styf/synth-mate/docs/64500295_00_K.pdf

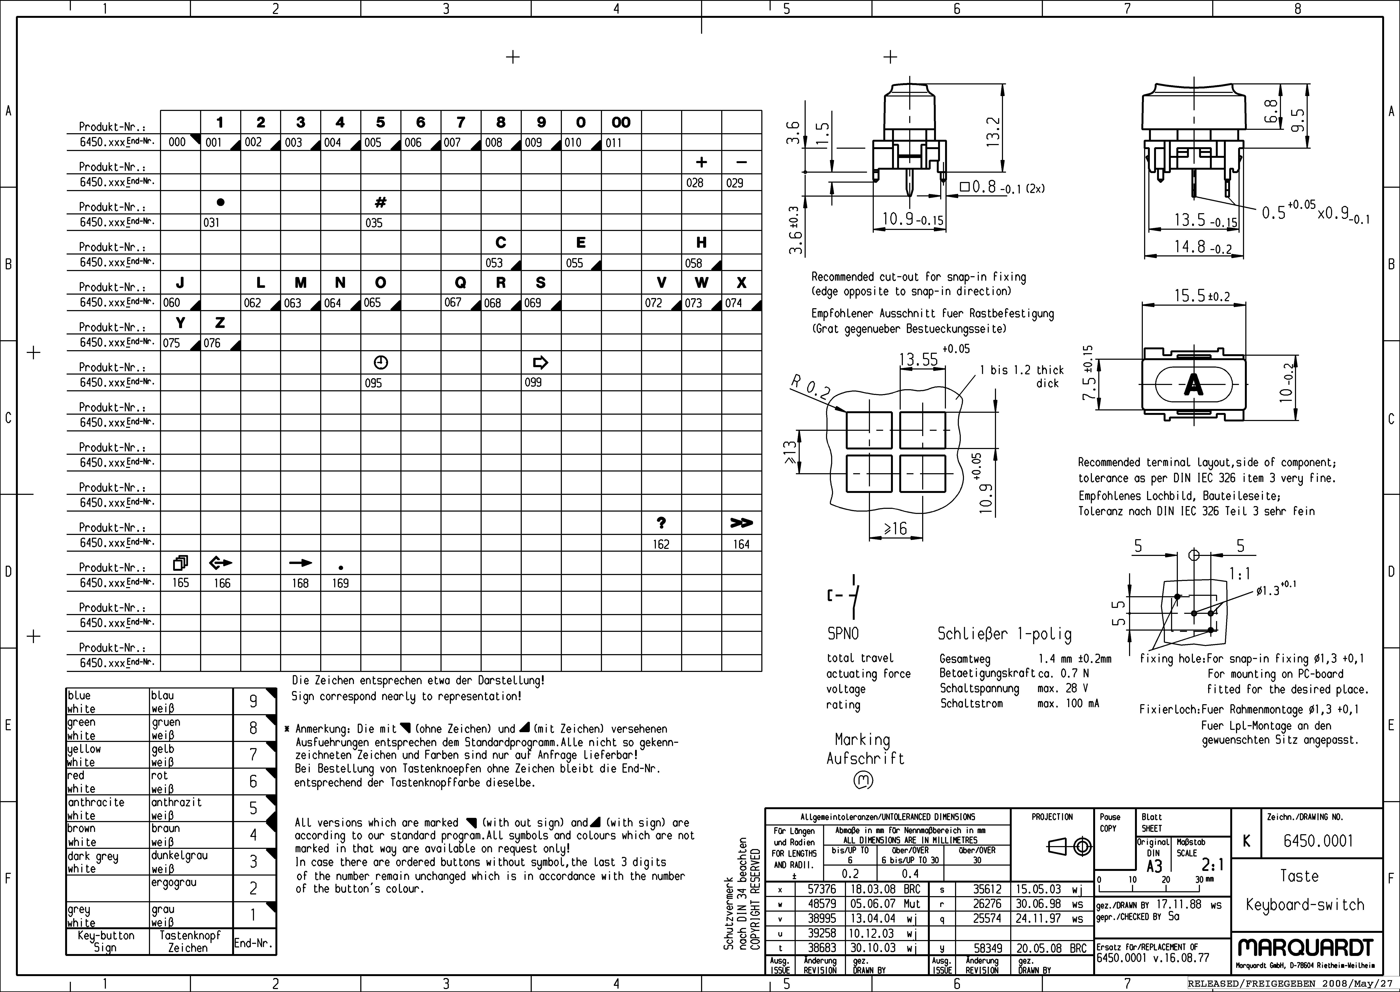
[picture p1: page 1]
