styf/synth-mate/synthmate_hyna_L432/synthmate_L432.step

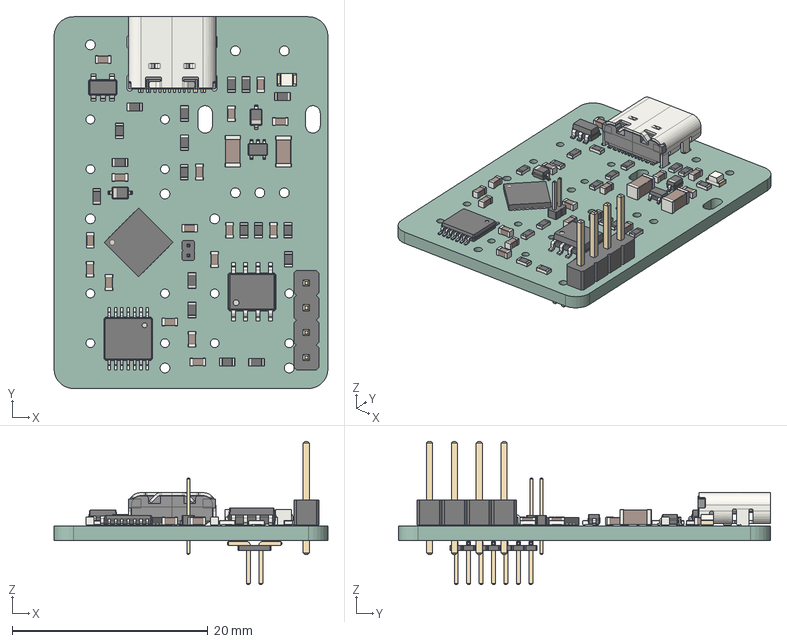
[picture p2: CAD file, 2026-01-29]
synthmate_hyna_L432/synthmate_L432.step
28.0 x 38.0 x 14.6 mm
PinHeader_1x04_P2.54mm_Vertical
TSSOP-14_4.4x5mm_P0.65mm
C_0603_1608Metric x 16
R_0603_1608Metric x 18
USB_C_Receptacle_GCT_USB4105-xx-A_16P_TopMnt_Horizontal
D_SOD-323 x 2
SOIC-8_3.9x4.9mm_P1.27mm
SOT-353_SC-70-5
SOT-23-5
LED_0805_2012Metric
C_1206_3216Metric x 2
QFN-32-1EP_5x5mm_P0.5mm_EP3.45x3.45mm
PinHeader_1x02_P1.00mm_Vertical
PinHeader_2x07_P1.27mm_Vertical_SMD
synthmate_L432_PCB
