styf/synth-mate/synthmate_hyna_L432/synthmate_L432.pdf

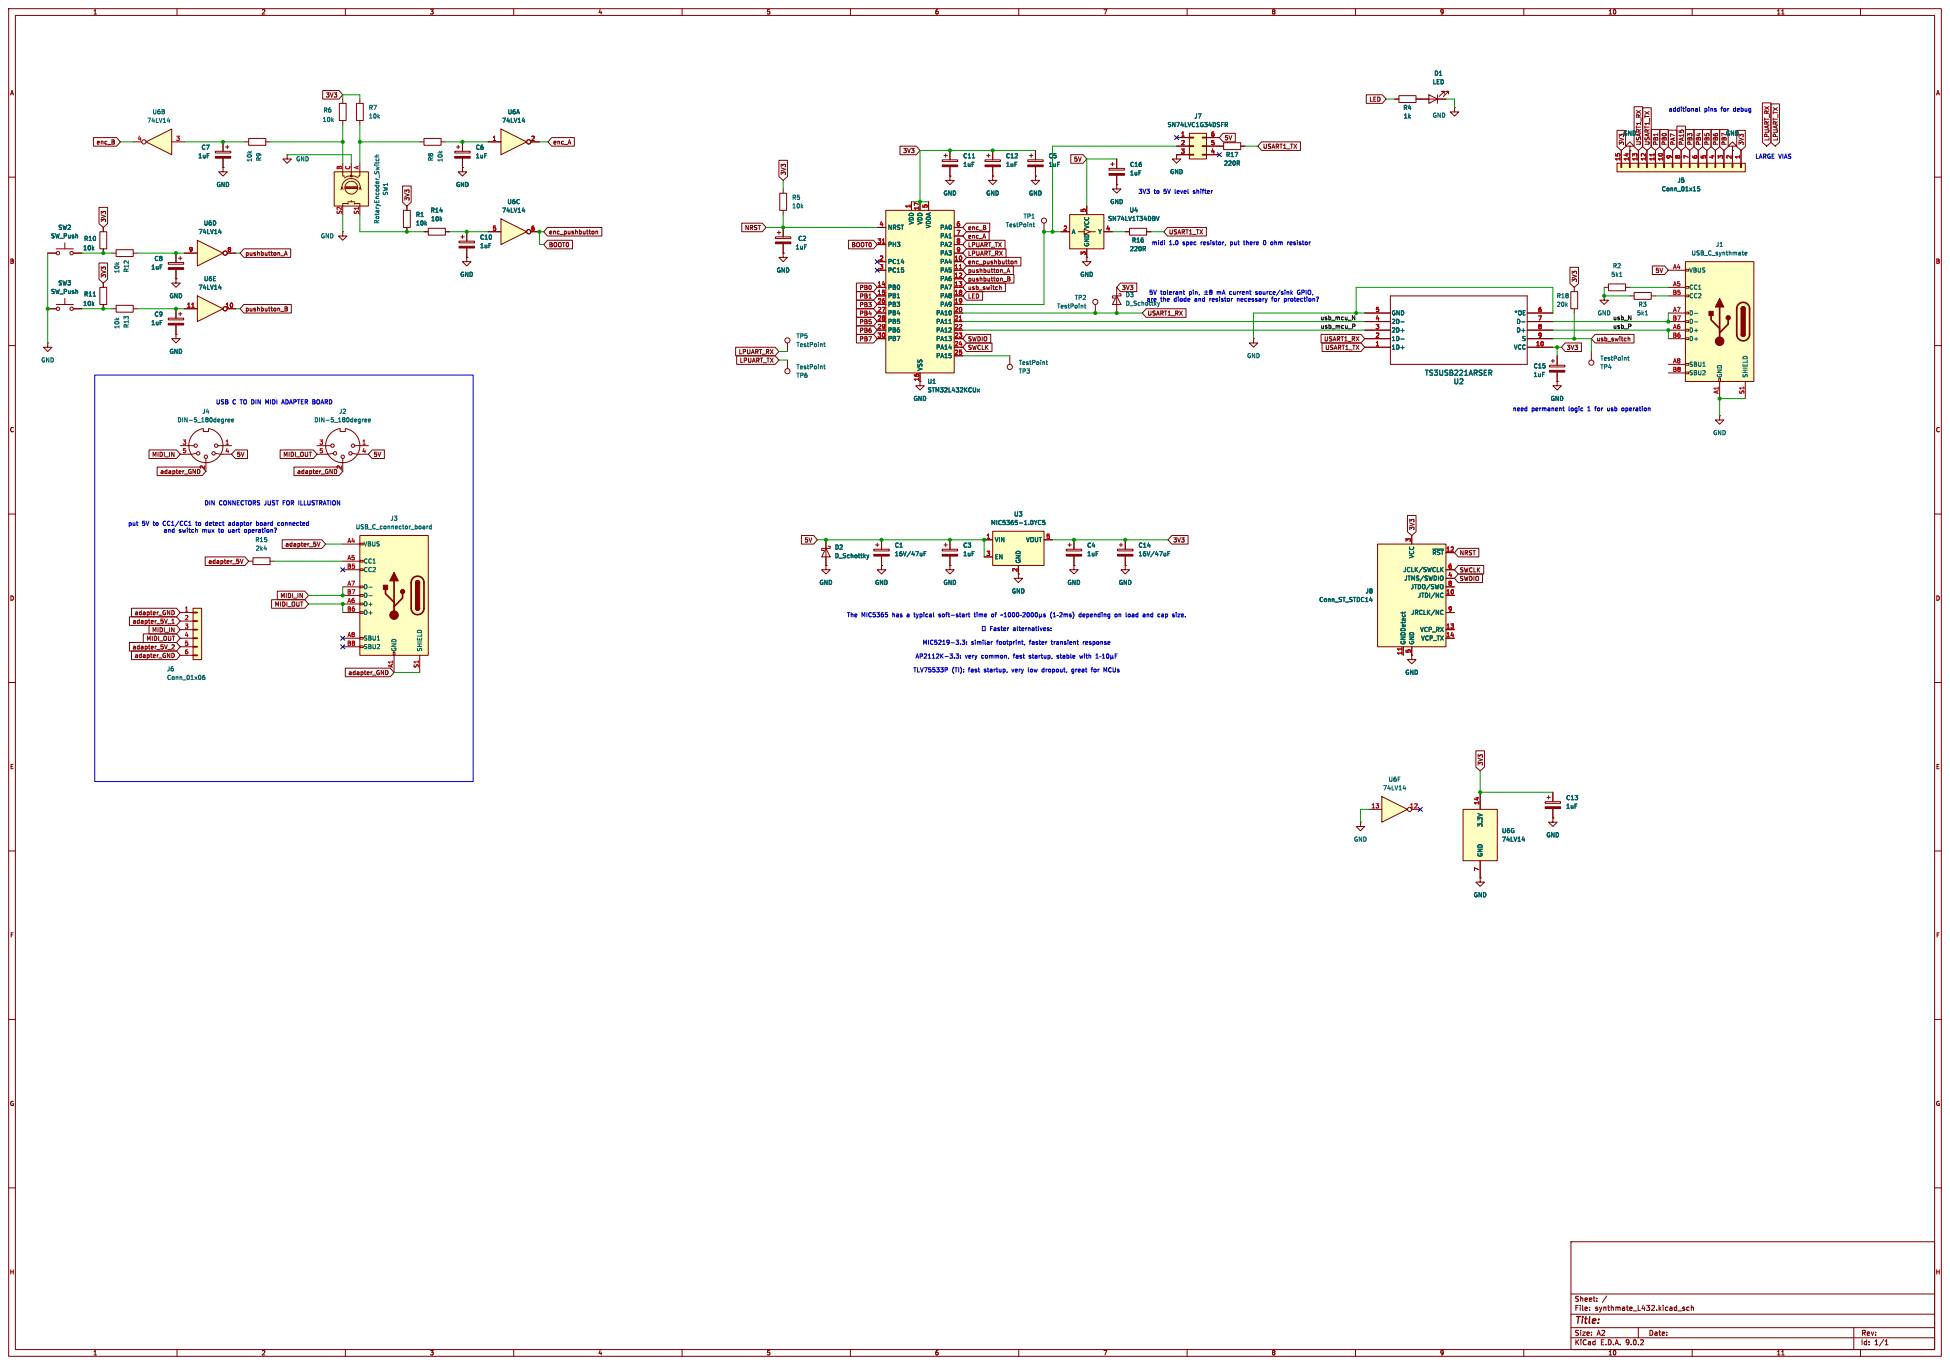
[picture p3: page 1]

usb_P DIN CONNECTORS JUST FOR ILLUSTRATION

USB C TO DIN MIDI ADAPTER BOARD

put 5V to CC1/CC1 to detect adaptor board connected

and switch mux to uart operation?
