styf/synth-mate/synthmate_hyna_L432/synthmate_L432.kicad_pcb

## KiCad design synthmate_hyna_L432/synthmate_L432.kicad_pcb (2026-01-23)

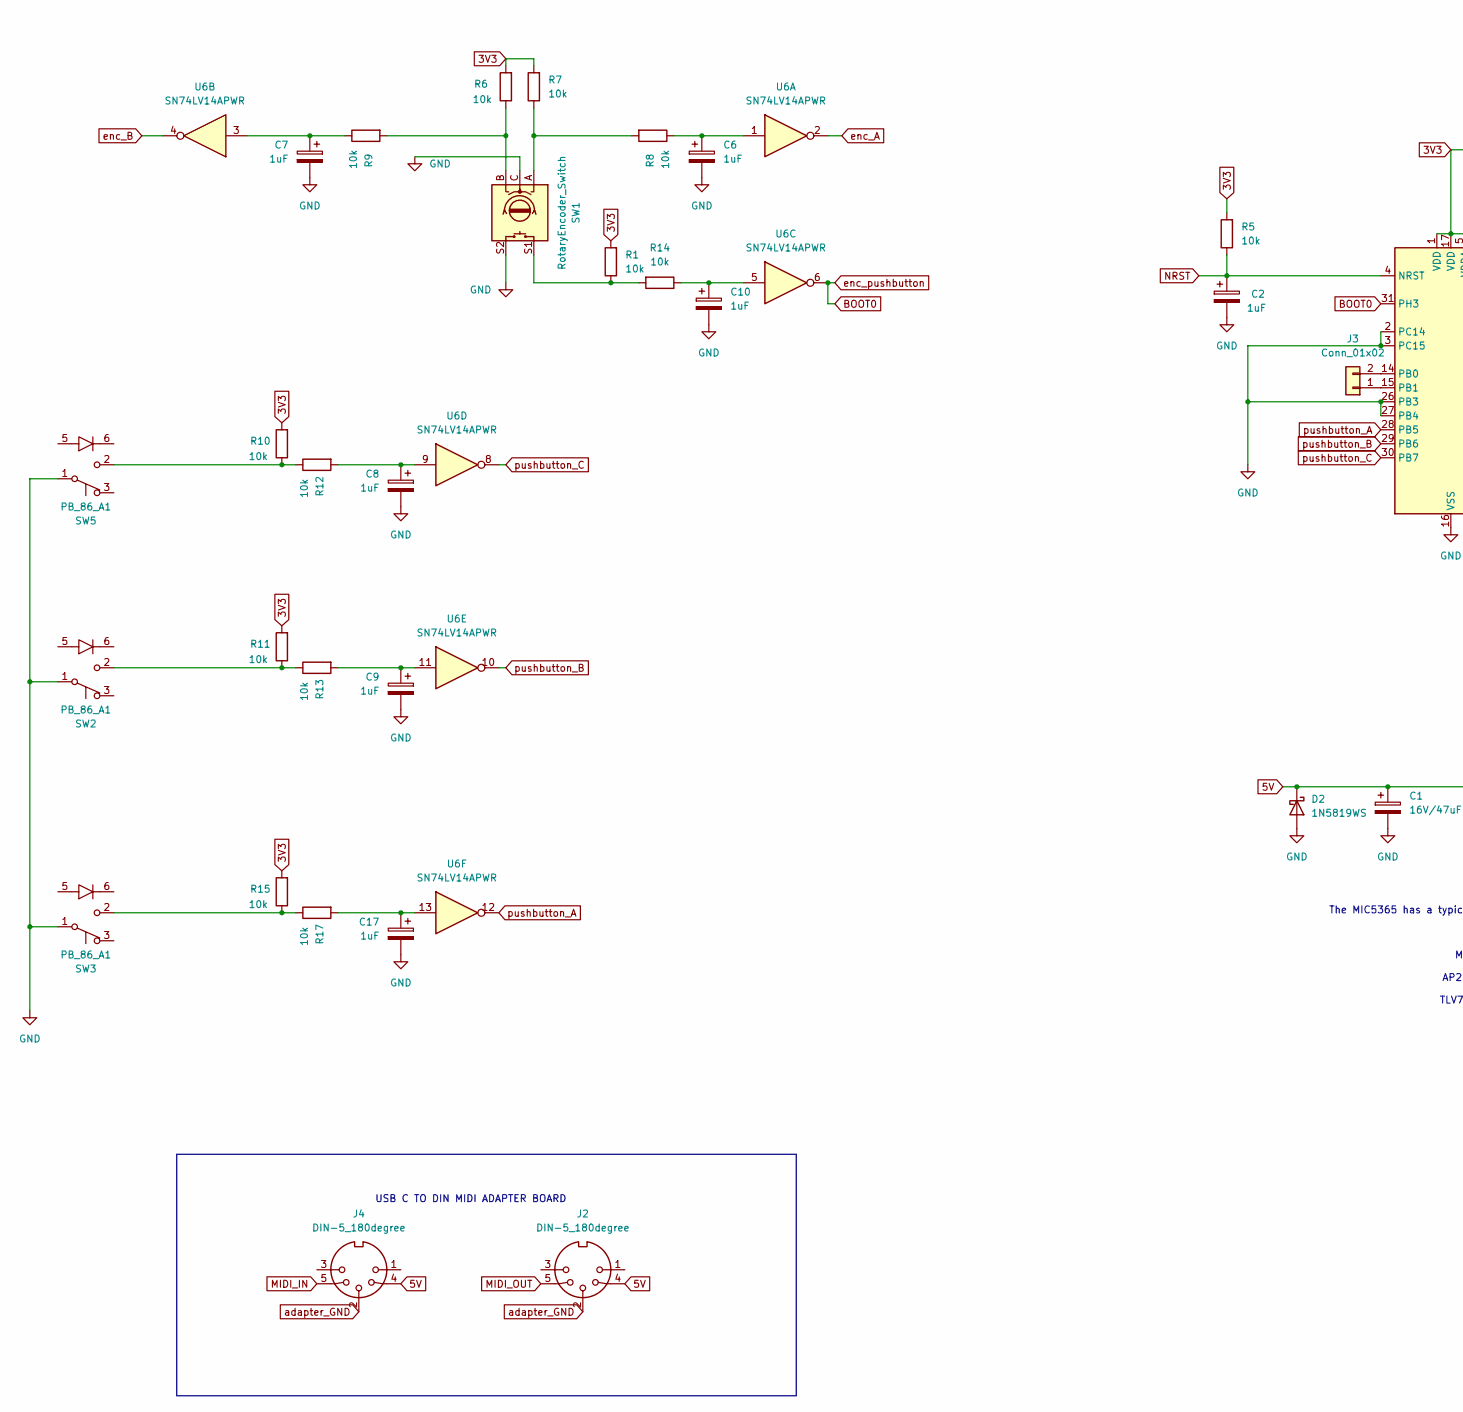
[picture p4: schematic synthmate_L432.kicad_sch, part in row 1, column 1]

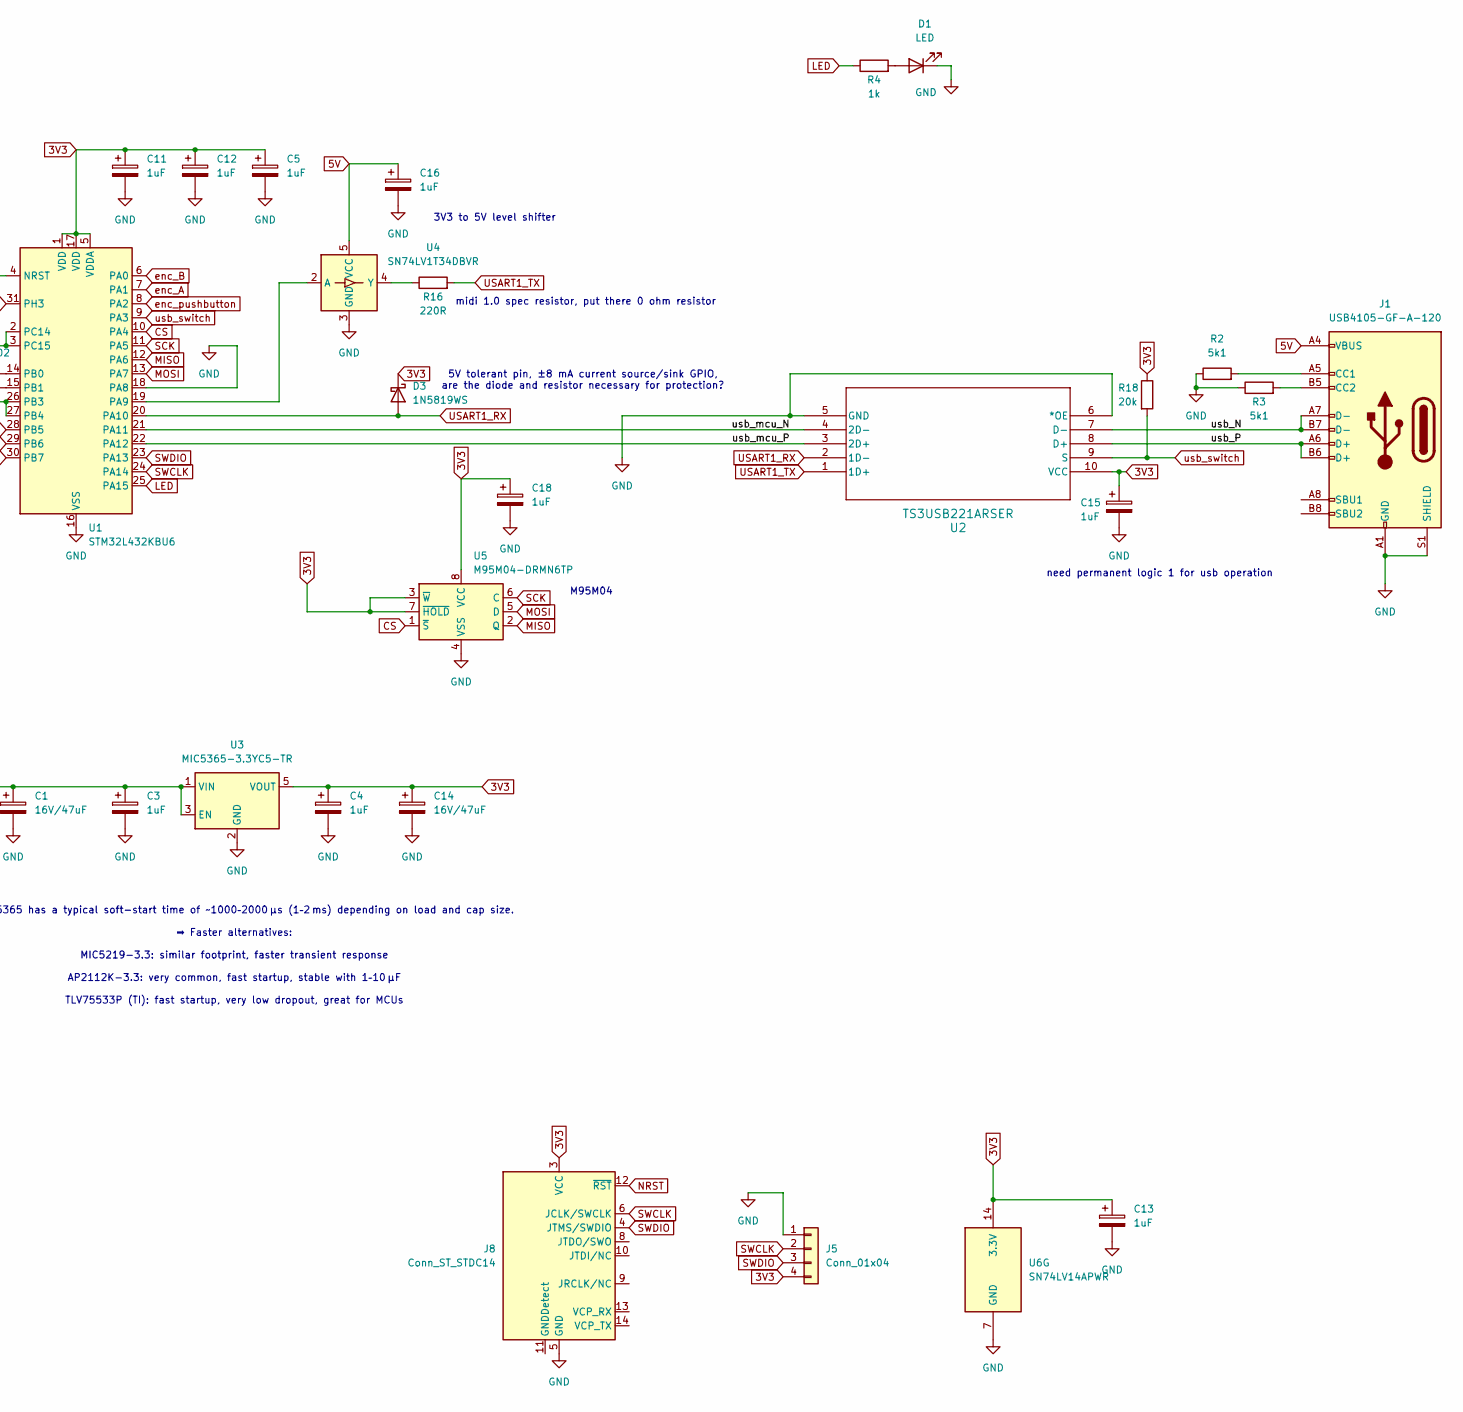
[picture p5: schematic synthmate_L432.kicad_sch, part in row 1, column 2]

Parts:
C1, C14: 16V/47uF; C_1206_3216Metric
C2, C3, C4, C5, C6, C7, C8, C9, C10, C11, C12, C13, C15, C16, C17, C18: 1uF; C_0603_1608Metric
D1: LED; LED_0805_2012Metric_Pad1.15x1.40mm_HandSolder
D2, D3: 1N5819WS; D_SOD-323
J1: USB4105-GF-A-120; USB_C_Receptacle_GCT_USB4105-xx-A_16P_TopMnt_Horizontal
J2, J4: DIN-5_180degree
J3: Conn_01x02; PinHeader_1x02_P1.00mm_Vertical
J5: Conn_01x04; PinHeader_1x04_P2.54mm_Vertical
J8: Conn_ST_STDC14; PinHeader_2x07_P1.27mm_Vertical_SMD
R1, R5, R6, R7, R8, R9, R10, R11, R12, R13, R14, R15, R17: 10k; R_0603_1608Metric
R2, R3: 5k1; R_0603_1608Metric
R4: 1k; R_0603_1608Metric
R16: 220R; R_0603_1608Metric
R18: 20k; R_0603_1608Metric
SW1: RotaryEncoder_Switch; RotaryEncoder_Alps_EC11E-Switch_Vertical_H20mm
SW2, SW3, SW5: PB_86_A1; PB_86_A0
U1: STM32L432KBU6; QFN-32-1EP_5x5mm_P0.5mm_EP3.45x3.45mm
U2: TS3USB221ARSER; RSE10
U3: MIC5365-3.3YC5-TR; SOT-353_SC-70-5
U4: SN74LV1T34DBVR; SOT-23-5
U5: M95M04-DRMN6TP; SOIC-8_3.9x4.9mm_P1.27mm
U6: SN74LV14APWR; TSSOP-14_4.4x5mm_P0.65mm

Connections:
3V3: C4.1, C5.1, C11.1, C12.1, C13.1, C14.1, C15.1, C18.1, D3.1 (K), J5.4, J8.3 (VCC), R1.2, R5.2, R6.2, R7.2, R10.2, R11.2, R15.2, R18.1, U1.1 (VDD), U1.5 (VDDA), U1.17 (VDD), U2.10 (VCC), U3.5 (VOUT), U5.3 (~W), U5.7 (~HOLD), U5.8 (VCC), U6.14 (3.3V)
5V: C1.1, C3.1, C16.1, D2.1 (K), J1.A4 (VBUS), J1.A9 (VBUS), J1.B4 (VBUS), J1.B9 (VBUS), J2.4, J4.4, U3.1 (VIN), U3.3 (EN), U4.5 (VCC)
/usb_N: J1.A7 (D-), J1.B7 (D-), U2.7 (D-)
/usb_P: J1.A6 (D+), J1.B6 (D+), U2.8 (D+)
/usb_mcu_N: U1.21 (PA11), U2.4 (2D-)
/usb_mcu_P: U1.22 (PA12), U2.3 (2D+)
BOOT0: U1.8 (PA2), U1.31 (PH3), U6.6
CS: U1.10 (PA4), U5.1 (~S)
GND: C1.2, C2.2, C3.2, C4.2, C5.2, C6.2, C7.2, C8.2, C9.2, C10.2, C11.2, C12.2, C13.2, C14.2, C15.2, C16.2, C17.2, C18.2, D1.1 (K), D2.2 (A), J1.A1 (GND), J1.A12 (GND), J1.B1 (GND), J1.B12 (GND), J1.S1 (SHIELD), J5.1, J8.5 (GND), J8.7 (GND), R2.1, R3.1, SW1.C, SW1.S2, SW2.1 (B), SW3.1 (B), SW5.1 (B), U1.2 (PC14), U1.3 (PC15), U1.16 (VSS), U1.18 (PA8), U1.26 (PB3), U1.27 (PB4), U1.32 (VSS), U1.33 (VSS), U2.5 (GND), U2.6 (*OE), U3.2 (GND), U4.3 (GND), U5.4 (VSS), U6.7 (GND)
LED: R4.1, U1.25 (PA15)
MISO: U1.12 (PA6), U5.2 (Q)
MOSI: U1.13 (PA7), U5.5 (D)
NRST: C2.1, J8.12 (~RST), R5.1, U1.4 (NRST)
unnamed: C6.1, R8.1, U6.1
unnamed: C7.1, R9.1, U6.3
unnamed: C8.1, R12.2, U6.9
unnamed: C9.1, R13.2, U6.11
unnamed: C10.1, R14.1, U6.5
unnamed: C17.1, R17.2, U6.13
unnamed: D1.2 (A), R4.2
unnamed: J1.A5 (CC1), R2.2
unnamed: J1.B5 (CC2), R3.2
unnamed: J2.2, J4.2
unnamed: J3.1, U1.15 (PB1)
unnamed: J3.2, U1.14 (PB0)
unnamed: R1.1, R14.2, SW1.S1
unnamed: R6.1, R9.2, SW1.B
unnamed: R7.1, R8.2, SW1.A
unnamed: R11.1, R13.1, SW2.2 (C)
unnamed: R15.1, R17.1, SW3.2 (C)
unnamed: R10.1, R12.1, SW5.2 (C)
unnamed: U1.19 (PA9), U4.2 (A)
unnamed: R16.1, U4.4 (Y)
SCK: U1.11 (PA5), U5.6 (C)
SWCLK: J5.2, J8.6 (JCLK/SWCLK), U1.24 (PA14)
SWDIO: J5.3, J8.4 (JTMS/SWDIO), U1.23 (PA13)
USART1_RX: D3.2 (A), U1.20 (PA10), U2.2 (1D-)
USART1_TX: R16.2, U2.1 (1D+)
enc_A: U1.7 (PA1), U6.2
enc_B: U1.6 (PA0), U6.4
pushbutton_A: U1.28 (PB5), U6.12
pushbutton_B: U1.29 (PB6), U6.10
pushbutton_C: U1.30 (PB7), U6.8
usb_switch: R18.2, U1.9 (PA3), U2.9 (S)

Notes on the sheet:
The MIC5365 has a typical soft-start time of ~1000–2000 µs (1–2 ms) depending on load and cap size. ➡️ Faster alternatives: MIC5219-3.3: similar footprint, faster transient response AP2112K-3.3: very common, fast startup, stable with 1–10 µF TLV75533P (TI): fast startup, very low dropout, great for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
M95M04
5V tolerant pin, ±8 mA current source/sink GPIO, are the diode and resistor necessary for protection?
3V3 to 5V level shifter
need permanent logic 1 for usb operation
USB C TO DIN MIDI ADAPTER BOARD
midi 1.0 spec resistor, put there 0 ohm resistor

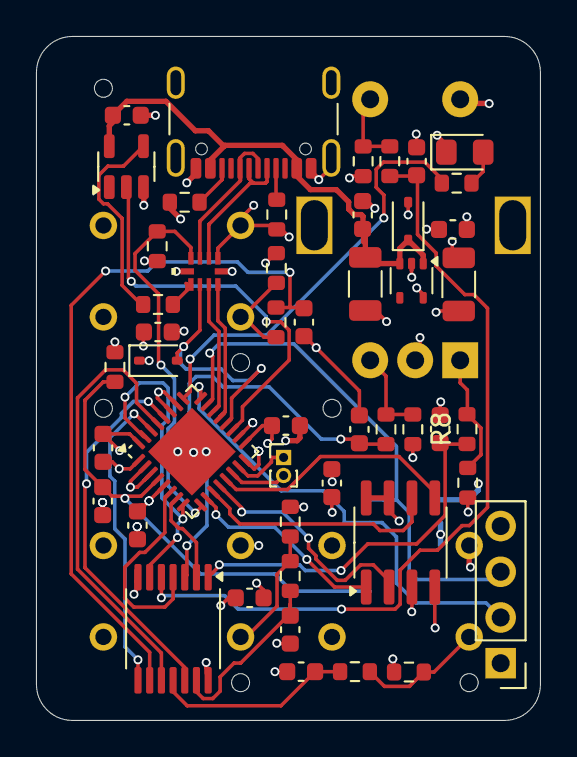
[picture p6: board synthmate_hyna_L432/synthmate_L432.kicad_pcb from above]

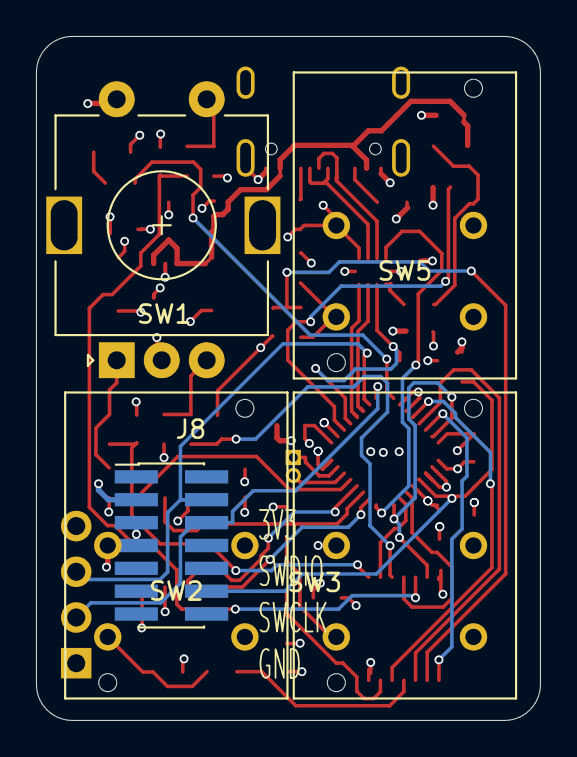
[picture p7: board synthmate_hyna_L432/synthmate_L432.kicad_pcb from below]

Board: 4 copper layers, 28.0 x 38.0 mm, 53 parts (5 on the bottom side), 43 nets.
