styf/synth-mate/synthmate_L432/synthmate_L432.kicad_pcb

## KiCad design synthmate_L432/synthmate_L432.kicad_pcb (2025-06-26)

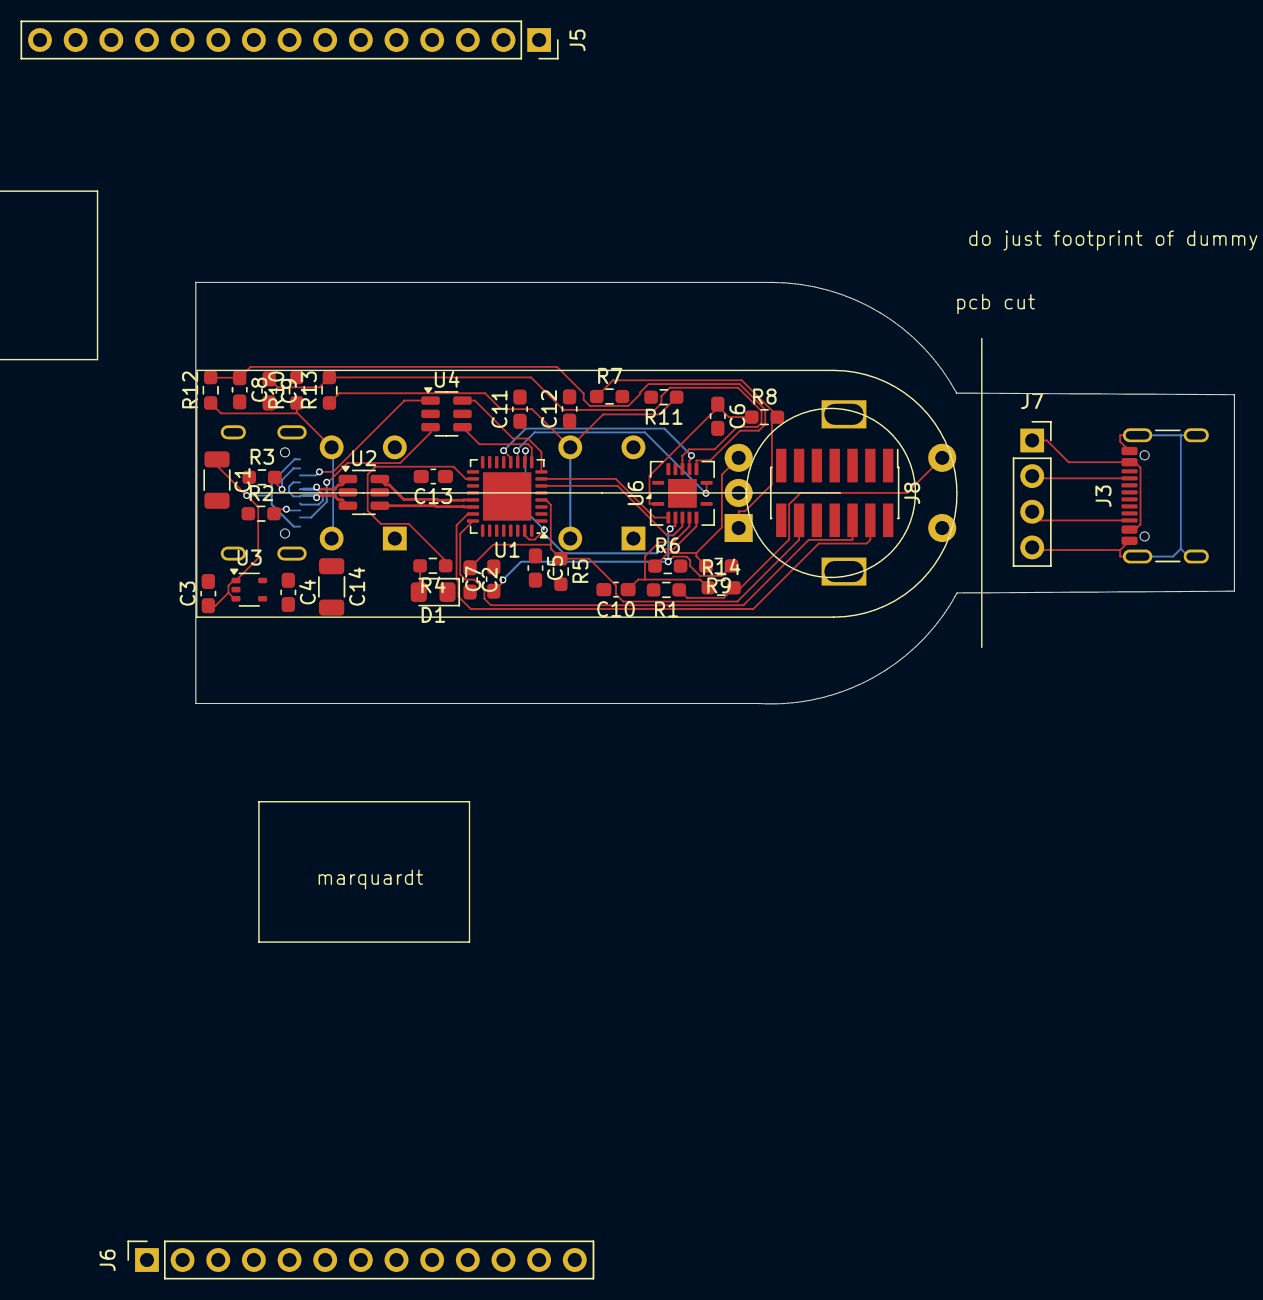
[picture p8: board synthmate_L432/synthmate_L432.kicad_pcb from above]

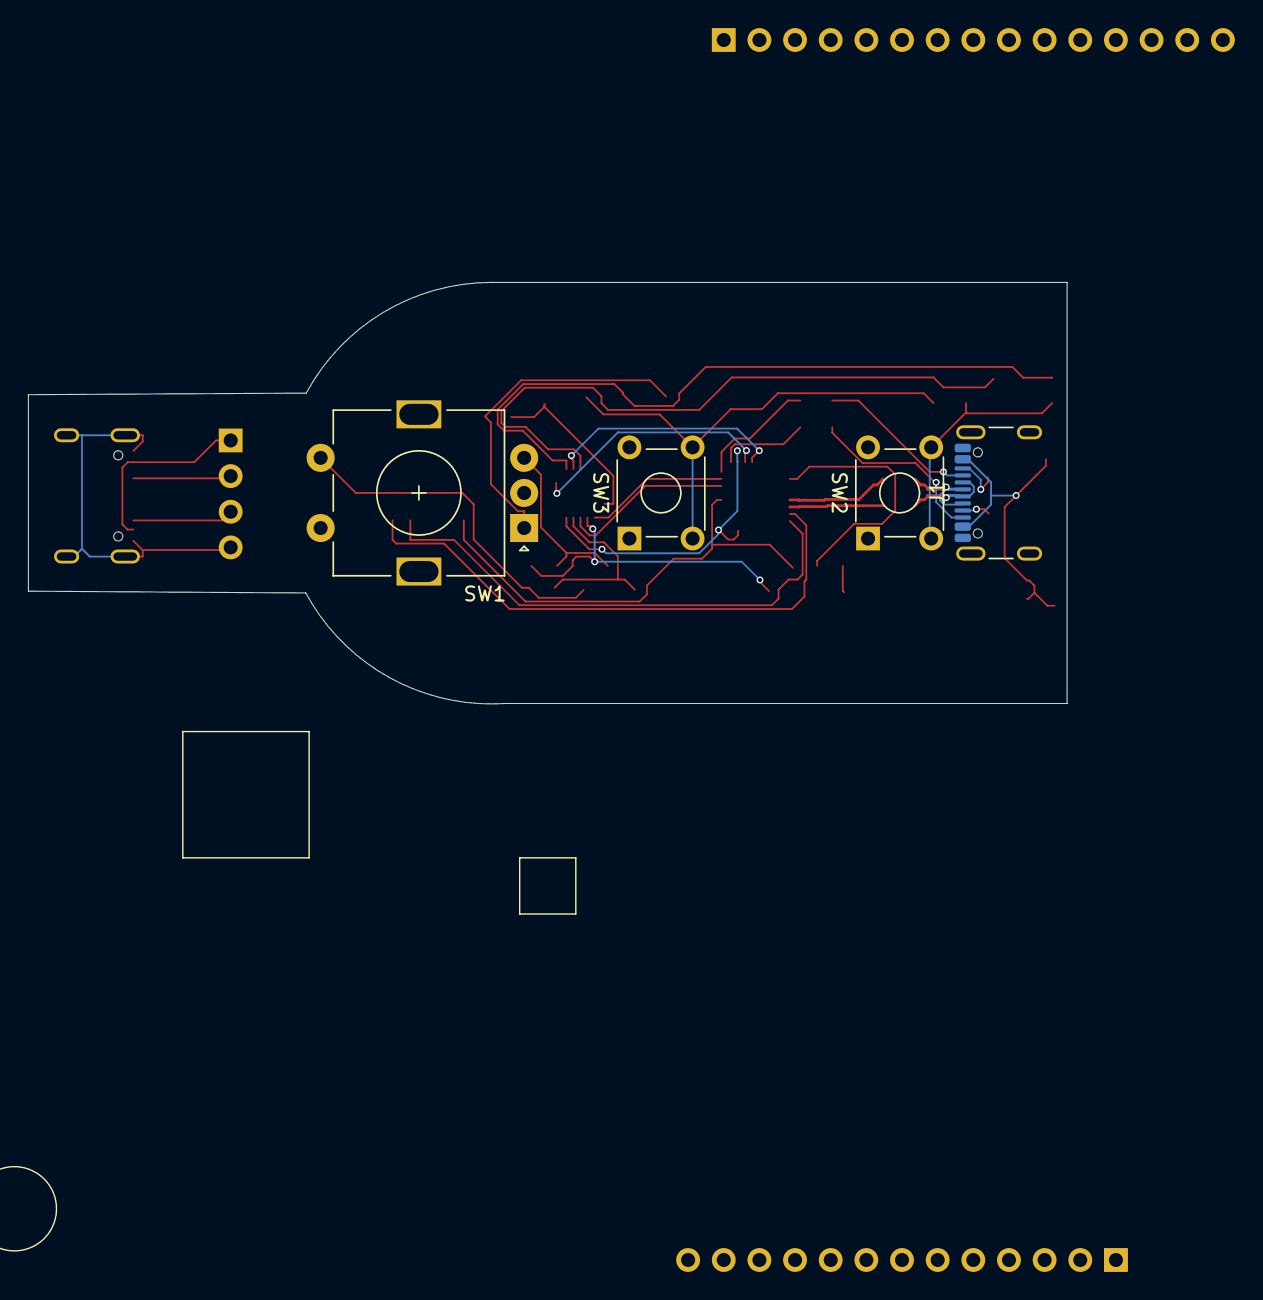
[picture p9: board synthmate_L432/synthmate_L432.kicad_pcb from below]

Board: 4 copper layers, 74.0 x 30.0 mm, 43 parts (4 on the bottom side), 37 nets.

Parts:
C1, C14: 16V/47uF; C_1206_3216Metric
C2, C5, C6, C7, C8, C9, C10, C11, C12: 100nF; C_0603_1608Metric_Pad1.08x0.95mm_HandSolder
C3, C4, C13: 1uF; C_0603_1608Metric_Pad1.08x0.95mm_HandSolder
D1: LED; LED_0805_2012Metric_Pad1.15x1.40mm_HandSolder
J1: USB_C_synthmate; USB_C_Receptacle_GCT_USB4105-xx-A_16P_TopMnt_Horizontal
J3: USB_C_connector_board; USB_C_Receptacle_GCT_USB4105-xx-A_16P_TopMnt_Horizontal
J5: Conn_01x16; PinSocket_1x15_P2.54mm_Vertical
J6: Conn_01x13; PinSocket_1x13_P2.54mm_Vertical
J7: Conn_01x04; PinSocket_1x04_P2.54mm_Vertical
J8: Conn_ST_STDC14; PinHeader_2x07_P1.27mm_Vertical_SMD
R1, R5, R6, R7, R8, R9, R10, R11, R12, R13, R14: 10k; R_0603_1608Metric_Pad0.98x0.95mm_HandSolder
R2, R3: 5k1; R_0603_1608Metric_Pad0.98x0.95mm_HandSolder
R4: 1k; R_0603_1608Metric_Pad0.98x0.95mm_HandSolder
SW1: RotaryEncoder_Switch; RotaryEncoder_Alps_EC11E-Switch_Vertical_H20mm
SW2, SW3: SW_Push; SW_TH_Tactile_Omron_B3F-10xx
U1: STM32L432KCUx; QFN-32-1EP_5x5mm_P0.5mm_EP3.45x3.45mm
U2, U4: USBLC6-2SC6; SOT-23-6
U3: MIC5365-1.0YC5; SOT-353_SC-70-5
U6: 74LV14; Texas_S-PVQFN-N14

Connections:
3V3: C4.1, C5.1, C11.1, C12.1, C13.1, C14.1, J8.3 (VCC), R1.2, R5.2, R6.2, R7.2, R10.2, R11.2, U1.1 (VDD), U1.5 (VDDA), U1.17 (VDD), U2.5 (VBUS), U3.5 (VOUT), U4.5 (VBUS), U6.14 (3.3V)
5V: C1.1, C3.1, J1.A4 (VBUS), J1.A9 (VBUS), J1.B4 (VBUS), J1.B9 (VBUS), U3.1 (VIN), U3.3 (EN)
/usb+: U1.22 (PA12), U2.4 (I/O2)
/usb-: U1.21 (PA11), U2.6 (I/O1)
/usb_N: J1.A7 (D-), J1.B7 (D-), U2.1 (I/O1)
/usb_P: J1.A6 (D+), J1.B6 (D+), U2.3 (I/O2)
BOOT0: U1.10 (PA4), U1.31 (PH3), U6.6
GND: C1.2, C2.2, C3.2, C4.2, C5.2, C6.2, C7.2, C8.2, C9.2, C10.2, C11.2, C12.2, C13.2, C14.2, D1.1 (K), J1.A1 (GND), J1.A12 (GND), J1.B1 (GND), J1.B12 (GND), J1.S1 (SHIELD), J8.5 (GND), J8.7 (GND), R2.1, R3.1, SW1.C, SW1.S2, SW2.1, SW3.1, U1.16 (VSS), U1.32 (VSS), U1.33 (VSS), U2.2 (GND), U3.2 (GND), U4.2 (GND), U6.7 (GND), U6.13
LED: R4.1, U1.18 (PA8)
LPUART_RX: U1.9 (PA3), U4.4 (I/O2)
LPUART_TX: U1.8 (PA2), U4.6 (I/O1)
NRST: C2.1, J8.12 (~RST), R5.1, U1.4 (NRST)
unnamed: C6.1, R8.1, U6.1
unnamed: C7.1, R9.1, U6.3
unnamed: C8.1, R12.2, U6.9
unnamed: C9.1, R13.2, U6.11
unnamed: C10.1, R14.1, U6.5
unnamed: D1.2 (A), R4.2
unnamed: J1.A5 (CC1), R2.2
unnamed: J1.B5 (CC2), R3.2
unnamed: J1.A8 (SBU1), U4.1 (I/O1)
unnamed: J1.B8 (SBU2), U4.3 (I/O2)
unnamed: R1.1, R14.2, SW1.S1
unnamed: R6.1, R9.2, SW1.B
unnamed: R7.1, R8.2, SW1.A
unnamed: R10.1, R12.1, SW2.2
unnamed: R11.1, R13.1, SW3.2
SWCLK: J8.6 (JCLK/SWCLK), U1.24 (PA14)
SWDIO: J8.4 (JTMS/SWDIO), U1.23 (PA13)
adaptor_5V: J3.A4 (VBUS), J3.A9 (VBUS), J3.B4 (VBUS), J3.B9 (VBUS), J7.1
adaptor_GND: J3.A1 (GND), J3.A12 (GND), J3.B1 (GND), J3.B12 (GND), J3.S1 (SHIELD), J7.4
adaptor_LPUART_RX: J3.A8 (SBU1), J7.2
adaptor_LPUART_TX: J3.B8 (SBU2), J7.3
enc_A: U1.7 (PA1), U6.2
enc_B: U1.6 (PA0), U6.4
pushbutton_A: U1.11 (PA5), U6.8
pushbutton_B: U1.12 (PA6), U6.10
