styf/synth-mate/(commit log)

2020-06-02 switch nrpn/ctlin
2025-06-04 pin headers, led, usart1
    [synthmate_L432.kicad_pcb, synthmate_L432.kicad_sch]
2025-06-18 switch to 4 layers, top layer signals routed
    [synthmate_L432.kicad_pcb, synthmate_L432.kicad_sch]
2025-06-21 added debounce
    [synthmate_L432.kicad_pcb, synthmate_L432.kicad_sch]
2025-06-21 pcb outline
    [synthmate_L432.kicad_pcb]
2025-06-26 74LV14 / TPD4E02B04DQA
    changed schmitt to 74LV14 and ESD to TPD4E02B04DQA
    [synthmate_L432.kicad_pcb, synthmate_L432.kicad_sch]
2025-06-26 moved smd to bottom side, changed back to eusblc6
    [synthmate_L432.kicad_pcb]
2025-08-01 added analog mux on main board nd adapter board
    [synthmate_L432.kicad_sch]
2025-08-04 adapter board rx/tx switching logic
    [synthmate_L432.kicad_sch]
2025-08-09 adapter board cleanup, uart IO protection added
    [synthmate_L432.kicad_pcb]
2025-12-17 Revert "gerber_v2"
    This reverts commit a36cd725a38217f085e25e19cc21183ca66f7b8c.
    [serialmidi_in_out.ino]
2025-12-29 before autorouter, locked footprints and usb
    [bom.csv, designators.csv, positions.csv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]
2025-12-29 naming cleanup
    [bom.csv, designators.csv, positions.csv, synthmate_L432.kicad_pcb, synthmate_L432.kicad_sch, synthmate_L432.step]
2026-01-29 added LICENSE, looper, automation
    [synthmate_L432.step]
